z2amiller/ocn-ePaper/FABLOG.md

# Fab Log

| Date | Board | Rev | Gen | Gerber SHA256 | JLC Order # | Notes |
|---|---|---|---|---|---|---|
| 2026-11-07T12:04 | ocn-ePaper | 0.2 | 2 | dc16f0f80ee5 | | |
| 2026-11-07T14:50 | ocn-ePaper | 0.3 | 3 | da80d2ef14e1 | | |
| 2026-11-07T17:39 | ocn-ePaper | 0.3 | 4 | d34c7df82f49 | | |
| 2026-11-08T00:56 | ocn-ePaper | 0.3 | 5 | 7136906de5cc | | |
