z2amiller/ocn-ePaper/ocn-ePaper.kicad_pcb

## KiCad design ocn-ePaper.kicad_pcb (2026-11-08)

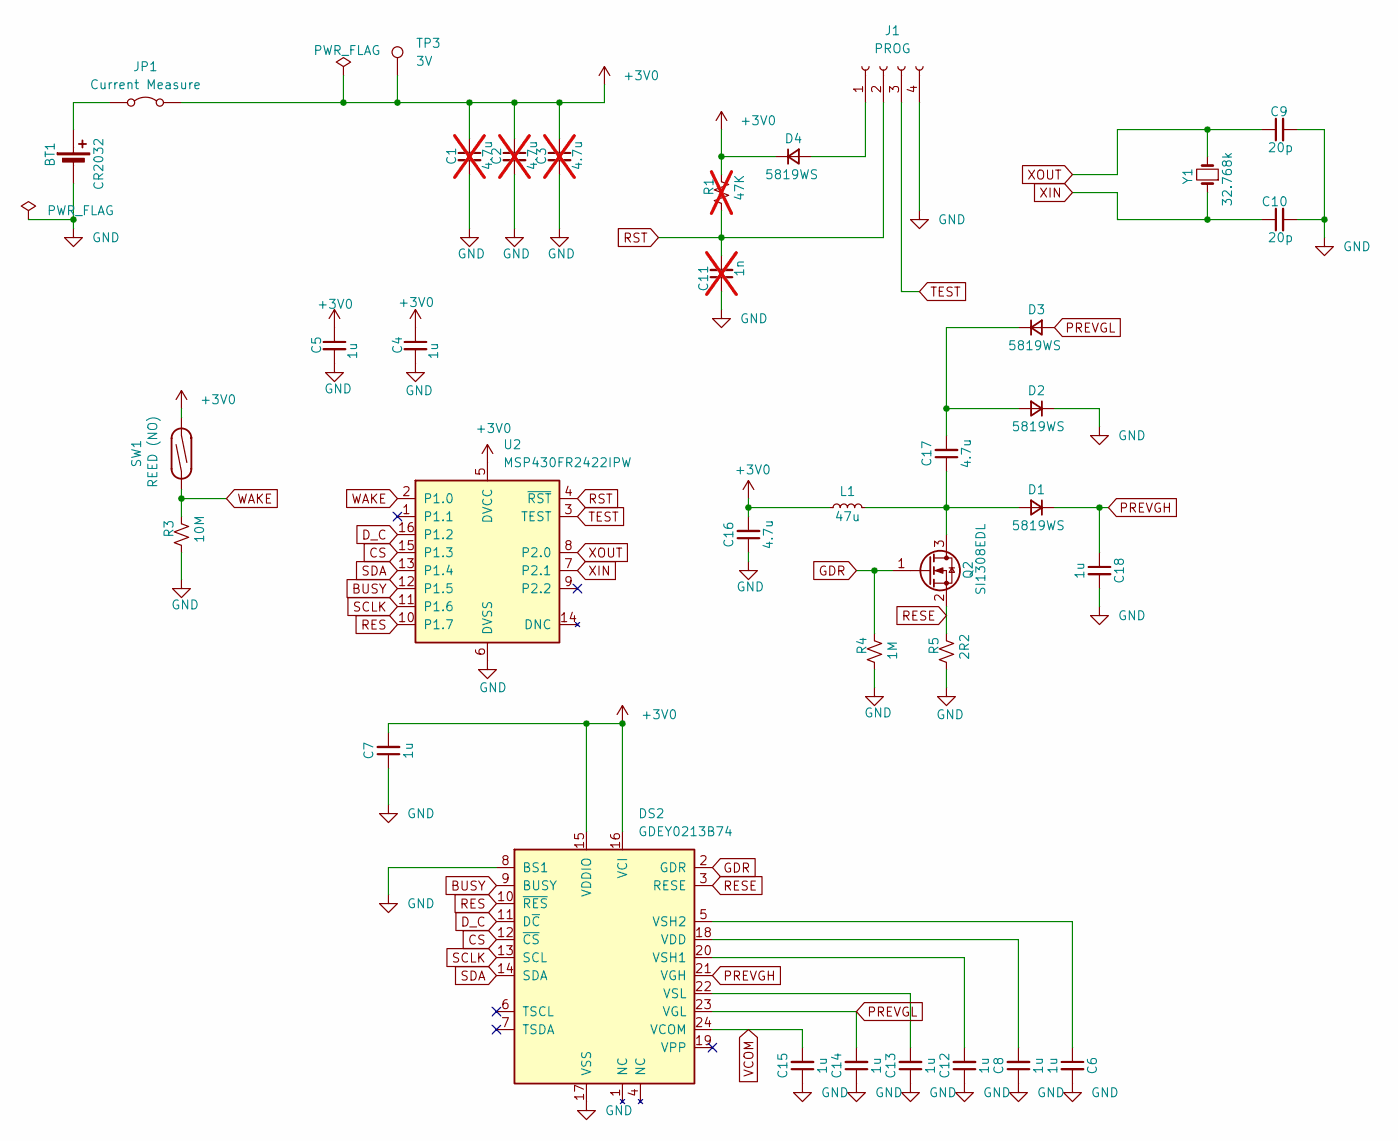
[picture p3: schematic ocn-ePaper.kicad_sch]

Parts:
BT1: CR2032; BatteryHolder_LianXin_BS-CR2032-8_1x2032; LCSC C7498149
C1, C2, C3: 4.7u; C_1206_3216Metric; LCSC C29823; not fitted
C4, C5, C6, C7, C8, C12, C13, C14, C15, C18: 1u; C_0603_1608Metric; LCSC C15849
C9, C10: 20p; C_0603_1608Metric; LCSC C1648
C11: 1n; C_0603_1608Metric; LCSC C1588; not fitted
C16, C17: 4.7u; C_1206_3216Metric; LCSC C29823
D1, D2, D3, D4: 5819WS; D_SOD-323F; LCSC C191023
DS2: GDEY0213B74; EPD_GDEY0213B74_WrappedToBack_Hirose_FH34SRJ-24S-0.5SH; LCSC C324726
J1: PROG; PinHeader_1x04_P2.54mm_Vertical
JP1: Current Measure; SolderJumper-2_P1.3mm_Bridged_Pad1.0x1.5mm
L1: 47u; L_Changjiang_FNR4030S; LCSC C167888
Q2: SI1308EDL; SOT-323_SC-70; LCSC C469327
R1: 47K; R_0603_1608Metric; LCSC C25819; not fitted
R3: 10M; R_0603_1608Metric; LCSC C7250
R4: 1M; R_0603_1608Metric; LCSC C22935
R5: 2R2; R_0603_1608Metric; LCSC C22939
SW1: REED (NO); SW_SPST_REED_Littelfuse_59170_GullWing; LCSC C315909
TP3: 3V; TestPoint_Pad_1.5x1.5mm
U2: MSP430FR2422IPW; TSSOP-16_4.4x5mm_P0.65mm; LCSC C191019
Y1: 32.768k; Crystal_SMD_3215-2Pin_3.2x1.5mm; LCSC C271654

Connections:
+3V0: C1.1, C2.1, C3.1, C4.1, C5.1, C7.2, C16.2, D4.1 (K), DS2.15 (VDDIO), DS2.16 (VCI), JP1.2 (B), L1.1, R1.1, SW1.2, TP3.1 (1_1), U2.5 (DVCC)
BUSY: DS2.9 (BUSY), U2.12 (P1.5)
CS: DS2.12 (~CS), U2.15 (P1.3)
D_C: DS2.11 (D~C), U2.16 (P1.2)
GDR: DS2.2 (GDR), Q2.1 (G), R4.1
GND: BT1.2 (-), C1.2, C2.2, C3.2, C4.2, C5.2, C6.2, C7.1, C8.1, C9.2, C10.2, C11.1, C12.1, C13.1, C14.1, C15.1, C16.1, C18.2, D2.1 (K), DS2.8 (BS1), DS2.17 (VSS), J1.4, R3.2, R4.2, R5.2, U2.6 (DVSS)
unnamed: BT1.1 (+), JP1.1 (A)
unnamed: C17.1, D1.2 (A), L1.2, Q2.3 (D)
unnamed: C17.2, D2.2 (A), D3.1 (K)
unnamed: D4.2 (A), J1.1
unnamed: C8.2, DS2.18 (VDD)
unnamed: C12.2, DS2.20 (VSH1)
unnamed: C6.1, DS2.5 (VSH2)
unnamed: C13.2, DS2.22 (VSL)
PREVGH: C18.1, D1.1 (K), DS2.21 (VGH)
PREVGL: C14.2, D3.2 (A), DS2.23 (VGL)
RES: DS2.10 (~RES), U2.10 (P1.7)
RESE: DS2.3 (RESE), Q2.2 (S), R5.1
RST: C11.2, J1.2, R1.2, U2.4 (~RST)
SCLK: DS2.13 (SCL), U2.11 (P1.6)
SDA: DS2.14 (SDA), U2.13 (P1.4)
TEST: J1.3, U2.3 (TEST)
VCOM: C15.2, DS2.24 (VCOM)
WAKE: R3.1, SW1.1, U2.2 (P1.0)
XIN: C10.1, U2.7 (P2.1), Y1.1
XOUT: C9.1, U2.8 (P2.0), Y1.2

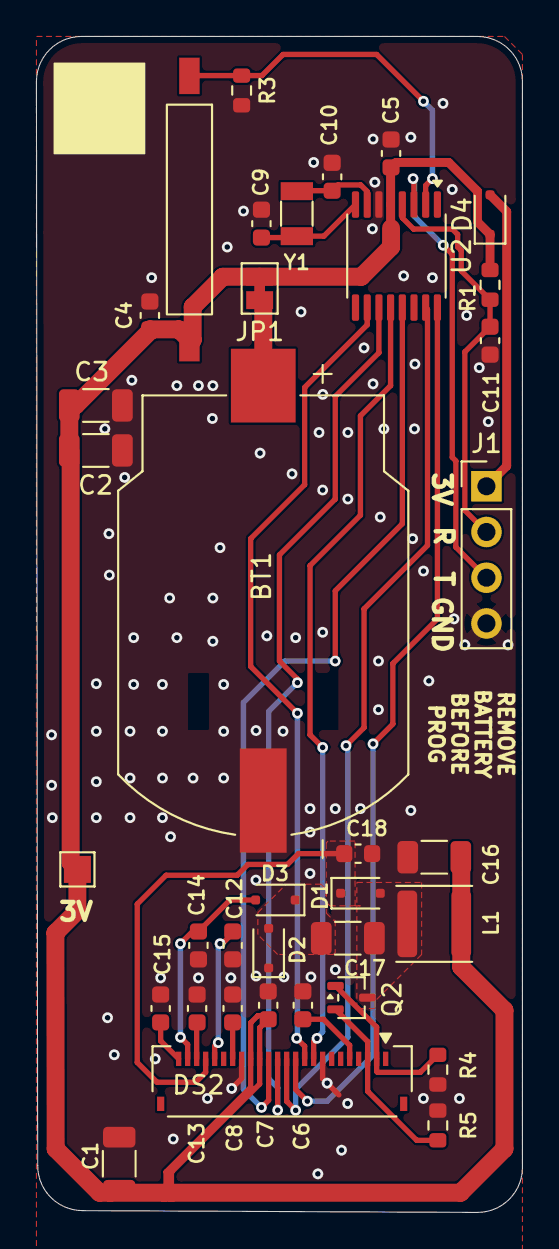
[picture p4: board ocn-ePaper.kicad_pcb from above]

Board: 2 copper layers, 27.0 x 65.3 mm, 36 parts (0 on the bottom side), 26 nets.
