z2amiller/ocn-ePaper/firmware/src/epd.c

// SPDX-License-Identifier: MIT
// Good Display GDEY0213B74 driver: SSD1680 over 4-wire SPI, write-only.
//
// Wiring (board.h): P1.2 D/C, P1.3 CS, P1.4 SDA (UCA0SIMO), P1.5 BUSY, P1.6 SCLK (UCA0CLK), P1.7 RES. SPI
// uses eUSCI_A0 on its default pins (SYSCFG3.USCIARMP = 0), transmit only: P1.5 would be its SOMI, but it
// stays a plain input for BUSY.
//
// The command sequence follows GxEPD2's driver for this panel (GxEPD2_213_B74) and Good Display's demo code:
// SW reset, 250 gate lines, X and Y incrementing, border waveform, display update control, internal
// temperature sensor. Full refresh is update sequence 0xF7 (display mode 1), partial is 0xFF (display mode 2,
// clock and analog off afterwards). Both RAMs are written every time (0x26 the previous count, 0x24 the new
// one), so a partial update doesn't depend on what the panel kept through deep sleep.
#include "board.h"
#include "epd.h"
#include "render.h"
#include "timer.h"

#define RESET_TICKS       TICKS(10)      // RES low, then high, 10 ms each (Good Display's demo)
#define BUSY_SHORT_TICKS  TICKS(200)     // reset and SW reset (typically a few ms)
#define BUSY_PART_TICKS   TICKS(3000)    // partial update (about 0.5 s)
#define BUSY_FULL_TICKS   TICKS(10000)   // full refresh (about 3.5 s; longer in the cold)
#define DURING_TICKS      TICKS(150)     // when epd_show's `during` callback runs, after the update starts

// DIAG=1 builds log each update into backup memory bytes 8-15 (main.c uses 0-7 and 16 on), for reading back
// with `make DIAG=1 readlog`:
//   8      BUSY just after the hardware reset (1 = high)
//   9      BUSY just after the update command (1 = high: the panel started an update)
//   10     bit 0: BUSY low after the reset; bit 1: after the SW reset; bit 2: after the update
//   11     updates so far (mod 256)
//   12-13  time BUSY stayed high after the SW reset, in 1/4096 s
//   14-15  time BUSY stayed high for the update, in 1/4096 s (about 12,000 for a 3 s full refresh)
#ifndef DIAG
#define DIAG 0
#endif
#define DG ((volatile uint8_t *)BKMEM_BASE)
static uint16_t busy_ticks;             // how long the last wait_busy() waited

// Sleeps until BUSY falls (the panel is done) or the timeout runs out. Returns 1 if BUSY is low. The Port 1
// interrupt (main.c) ends the sleep when BUSY falls.
static uint8_t wait_busy(uint16_t ticks)
{
    P1IES |= BUSY;                               // falling edge
    P1IFG &= ~BUSY;
    P1IE |= BUSY;
    timer_start(ticks);
    __disable_interrupt();
    while ((P1IN & BUSY) && !timer_expired) {    // checked with interrupts off, so an edge can't slip past
        __bis_SR_register(LPM3_bits | GIE);
        __disable_interrupt();
    }
    __enable_interrupt();
    busy_ticks = timer_now();
    timer_stop();
    P1IE &= ~BUSY;
    P1IFG &= ~BUSY;
    return !(P1IN & BUSY);
}

static void spi_on(void)
{
    UCA0CTLW0 = UCSWRST;
    UCA0CTLW0 |= UCCKPH | UCMSB | UCMST | UCSYNC | UCMODE_0 | UCSSEL__SMCLK;   // mode 0, MSB first
    UCA0BRW = 2;                                 // SMCLK 8 MHz / 2 = 4 MHz (the SSD1680 takes 20 MHz)
    SYSCFG3 &= ~USCIARMP;                        // SCLK on P1.6, SIMO on P1.4
    P1SEL0 |= SCK | SDA;
    UCA0CTLW0 &= ~UCSWRST;
}

static void spi_off(void)
{
    while (UCA0STATW & UCBUSY) {
    }
    UCA0CTLW0 = UCSWRST;
    P1SEL0 &= ~(SCK | SDA);                      // back to GPIO, driven low
}

static void spi_byte(uint8_t b)
{
    while (!(UCA0IFG & UCTXIFG)) {
    }
    UCA0TXBUF = b;
}

static void spi_drain(void)
{
    while (UCA0STATW & UCBUSY) {
    }
}

// Starts a command: CS low, the command byte with D/C low, then D/C high for its data.
static void begin(uint8_t c)
{
    P1OUT &= ~(DC | CS);
    spi_byte(c);
    spi_drain();
    P1OUT |= DC;
}

static void end(void)
{
    spi_drain();
    P1OUT |= CS;
    P1OUT &= ~DC;
}

static void command(uint8_t c, const uint8_t *data, uint8_t n)
{
    begin(c);
    while (n--) {
        spi_byte(*data++);
    }
    end();
}

#define CMD(c, ...) do { static const uint8_t a_[] = {__VA_ARGS__}; command((c), a_, sizeof a_); } while (0)
#define CMD0(c) command((c), 0, 0)

static void write_ram(uint8_t ram, const struct screen *s)
{
    CMD(0x4E, 0x00);                             // RAM X counter: byte 0
    CMD(0x4F, 0x00, 0x00);                       // RAM Y counter: row 0
    begin(ram);
    for (uint8_t row = 0; row < EPD_ROWS; row++) {
        uint8_t buf[EPD_ROW_BYTES];
        render_row(s, row, buf);
        for (uint8_t i = 0; i < EPD_ROW_BYTES; i++) {
            spi_byte(buf[i]);
        }
    }
    end();
}

uint8_t epd_show(const struct screen *old, const struct screen *now, uint8_t full, void (*during)(void))
{
    P1OUT &= ~RES;                               // hardware reset; also the way out of deep sleep
    timer_sleep(RESET_TICKS);
    P1OUT |= RES;
    timer_sleep(RESET_TICKS);
    if (DIAG) DG[8] = !!(P1IN & BUSY);
    spi_on();
    uint8_t ok1 = wait_busy(BUSY_SHORT_TICKS);
    CMD0(0x12);                                  // SW reset
    timer_sleep(RESET_TICKS);                    // "wait 10 ms" (Good Display's sequence), then for BUSY
    uint8_t ok2 = wait_busy(BUSY_SHORT_TICKS);
    if (DIAG) { DG[12] = (uint8_t)busy_ticks; DG[13] = (uint8_t)(busy_ticks >> 8); }
    CMD(0x01, 0xF9, 0x00, 0x00);                 // driver output: 250 gate lines
    CMD(0x11, 0x03);                             // data entry: X then Y, both incrementing
    CMD(0x44, 0x00, EPD_ROW_BYTES - 1);          // RAM X window: bytes 0-15
    CMD(0x45, 0x00, 0x00, EPD_ROWS - 1, 0x00);   // RAM Y window: rows 0-249
    if (full) {
        CMD(0x3C, 0x05);                         // border waveform for a full refresh
    } else {
        CMD(0x3C, 0x80);                         // border left alone during a partial update
    }
    CMD(0x21, 0x00, 0x80);                       // display update control
    CMD(0x18, 0x80);                             // internal temperature sensor
    write_ram(0x26, full ? now : old);           // the previous image, for display mode 2
    write_ram(0x24, now);                        // the new image
    if (full) {
        CMD(0x22, 0xF7);                         // clock + analog on, load temperature + LUT, mode 1, off
    } else {
        CMD(0x22, 0xFF);                         // the same with display mode 2 (partial)
    }
    CMD0(0x20);                                  // go
    if (DIAG) {
        __delay_cycles(800);                     // ~100 us for BUSY to rise
        DG[9] = !!(P1IN & BUSY);
    }
    if (during) {                                // a moment into the update, with the booster drawing current
        timer_sleep(DURING_TICKS);
        during();
    }
    uint8_t ok3 = wait_busy(full ? BUSY_FULL_TICKS : BUSY_PART_TICKS);
    if (during) busy_ticks += DURING_TICKS;      // DIAG: time from the start, not from the wake
    if (DIAG) {
        DG[14] = (uint8_t)busy_ticks;
        DG[15] = (uint8_t)(busy_ticks >> 8);
        DG[10] = (uint8_t)(ok1 | (ok2 << 1) | (ok3 << 2));
        DG[11] = (uint8_t)(DG[11] + 1);
    }
    uint8_t ok = ok1 & ok2 & ok3;
    CMD(0x10, 0x03);                             // deep sleep mode 2: 1 uA typ, RAM not kept (rewritten every
                                                 // update anyway); the RAM-keeping sleep is 20 uA. BUSY stays high.
    spi_off();
    return ok;
}
