z2amiller/ocn-ePaper/(commit log)

2026-10-04 ocn-ePaper v0.1: elapsed-time counter with e-paper display and magnetic off switch
    KiCad 10 project (MSP430FR2111, Good Display GDEY0213B74 2.13-inch e-paper
    with its tail folded under the panel into a Hirose FH34SRJ socket, the
    panel's boost converter, a CR123A on the back, and a normally open reed
    switch gating a P-channel MOSFET), with the board's own symbols and
    footprints in lib/ and project library tables pointing at them. README
    covers how it works, a power budget with runtime by display update rate,
    magnet placement, key parts, assembly and programming over Spy-Bi-Wire from
    an MSP430 LaunchPad. Licensed CERN-OHL-P v2.
    [ocn-ePaper.kicad_pcb, ocn-ePaper.kicad_sch]
2026-11-07 Firmware: count minutes to 99:59 on the GDEY0213B74, LPM3.5 between RTC wakes
    MSP430FR2111 + SSD1680: a partial update each minute and a full refresh
    after every five, drawn as seven-segment digits one RAM row at a time
    (the 3.8 KB frame doesn't fit in 1 KB of RAM). The panel sleeps in deep
    sleep mode 2 between updates; the supply supervisor stays on in LPM3.5 so
    a magnet that pulls the rail below ~1.8 V always restarts the count.
    Adapted from the ocn-LCD firmware; not yet run on a board.
    [epd.c, epd.h, main.c, render.c, render.h]
2026-11-07 Firmware: DIAG log of each panel update, LOOP refresh build, make readlog
    DIAG=1 records in backup memory whether BUSY rose after the update command
    and how long it stayed high, for reading back over Spy-Bi-Wire; it found
    the first board's panel powered but never answering (a bad joint, fixed by
    a second reflow). LOOP=1 refreshes back to back so a meter can catch the
    booster voltages.
    [epd.c, main.c]
2026-11-07 Firmware README: first-board measurements (about 24 uA averaged, 1.04 mC per partial update)
2026-11-07 ocn-ePaper 0.2 fab outputs (g2)
    [ocn-ePaper.kicad_pcb, ocn-ePaper.kicad_sch]
2026-11-07 Firmware: status line with the battery and the temperature under smaller digits
    The digits shrink to 80 px and a line along the bottom shows a battery gauge
    and voltage (the supply against the internal 1.5 V reference, read under the
    booster's load in the middle of each update) and the chip's temperature
    (TI's factory calibration at 30 and 85 C), in a 75-byte 5x7 font. It also
    shows which way up the panel is. Own division loops keep the library's
    divide routines out: 3.2 KB of the FR2111's 3.7 KB. RST's internal pull-up
    is set explicitly, so R1 and C11 can be left off.
2026-11-07 Firmware: settle the ADC reference 400 us before a reading, as TI's example does
    The power-up temperature on the first board still reads about 3 C high
    (23 C from the first minute on); the settle didn't change that, and the
    README and sense.c say so.
    [sense.c]
2026-11-07 lib: vendor the MSP430FR2422IPW symbol from kicad-lowpower-lib 174f7b6
2026-11-07 Firmware: stored-screen mock-up (SLEEPMOCK=1): the stopped time small, a graphic placeholder, the status line
    A layout study for a board with the reed on a GPIO: `make SLEEPMOCK=1
    START=hhmm flash` draws it once and sleeps. The digit drawing now takes its
    size from a table (large counting digits, small stored ones); the counting
    build leaves the stored screen out (STORED_SCREEN=0), at 3.2 KB.
2026-11-07 Firmware: stored-screen mock-up in portrait, battery only
    For a unit stored upright (MAGNET DISABLE end at the bottom): the stopped
    time across the top, a 110 x 137 graphic placeholder, the battery gauge and
    voltage at the bottom. Portrait is the panel's native RAM order, so it is
    drawn a row at a time with the same strokes transposed. The mock build
    carries only the stored screen and no counting code (2.7 KB); the counting
    build is unchanged at 3.2 KB. make preview STORED=1 shows it portrait.
2026-11-07 Firmware: stored screen reads with the MAGNET DISABLE end at the bottom
    The counting screen's picture turned 90 degrees clockwise, not counter-
    clockwise: on the first board the CCW version read upside down held that way.
2026-11-07 ocn-ePaper 0.3 fab outputs (g3)
    [ocn-ePaper.kicad_pcb, ocn-ePaper.kicad_sch]
2026-11-08 lib: vendor the BS-CR2032-8 coin cell holder footprint
    Copied unchanged from kicad-lowpower-lib (LCSC C7498149).
2026-11-08 ocn-ePaper 0.3 fab outputs (g4)
    [ocn-ePaper.kicad_pcb, ocn-ePaper.kicad_sch]
2026-11-08 lib: vendor the 6 mm spacer build of the folded GDEY0213B74 footprint
    Copied unchanged from kicad-lowpower-lib. Same pads as the 3 mm build; the panel lands 4.7 mm further from the
    fold, and the fold sticks out 4.8 mm past the panel edge.
2026-11-08 lib: vendor the wrapped-to-back GDEY0213B74 footprint
    The panel bonds display-out to the bare back of the board and its tail wraps
    round the bottom edge into the FH34SRJ on top. Pad n is Hirose contact n, the
    reverse of the FoldedUnder footprint, so swapping DS2 over mirrors the
    connector's fanout. The nominal board edge sits 7.42 mm from the connector
    origin.
2026-11-08 lib: BS-CR2032-8 keepouts now bar tracks and pours, drawn hatched
    The holder's spring-clip slots get copper keepouts (tracks, vias, pours)
    instead of via-only ones, fully hatched and outlined on Dwgs.User. The board
    picks them up with Update Footprints from Library on BT1.
2026-11-08 Firmware: port to the FR2422 board, with the magnet on a GPIO
    Revision 0.3 moves to an MSP430FR2422 with the reed switch on P1.0 (WAKE)
    instead of in the supply, so the chip stays powered and handles the magnet
    itself:
    - magnet off counts from 00:00 as before;
    - magnet on stops the count, keeping any minute not yet shown, and draws the
    stored screen, which the RTC redraws about weekly (295 wakes of 2,048 s);
    - every wake compares WAKE with the mode, and a change counts once the pin
    reads the same twice 20 ms apart; Port 1 is armed for the edge that would
    change the mode before each LPM3.5 sleep.
    Port details: the panel's pins all move to Port 1 (board.h), so BUSY shares
    the Port 1 int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
2026-11-08 ocn-ePaper 0.3 fab outputs (g5)
    [ocn-ePaper.kicad_pcb, ocn-ePaper.kicad_sch]
2026-11-08 Firmware: one CR2032, and keep the stopped time safe from a brownout
    The board has a single CR2032 (BT1), not two: the gauge text and thresholds
    now follow one cell read under load (bars at 2.75/2.62/2.50/2.40 V), with
    the empty level shared as BATTERY_EMPTY_CV.
    A cold or aged coin cell can brown out during the weekly stored-screen
    redraw. The reset used to start afresh and redraw the stored screen at
    00:00, overwriting the stopped time, and a weak cell could loop through
    refreshes. Now:
    - the stopped time also goes into information FRAM, and a start with the
    magnet on shows it from there;
    - each update is marked as under way in FRAM until it finishes, and a start
    that finds the mark dr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
    [main.c, render.c, render.h, sense.h]
